KevWal/BasicTracker/Hardware/BT-5/BT-5.brd

## EAGLE design Hardware/BT-5/BT-5.brd (2022-10-12)

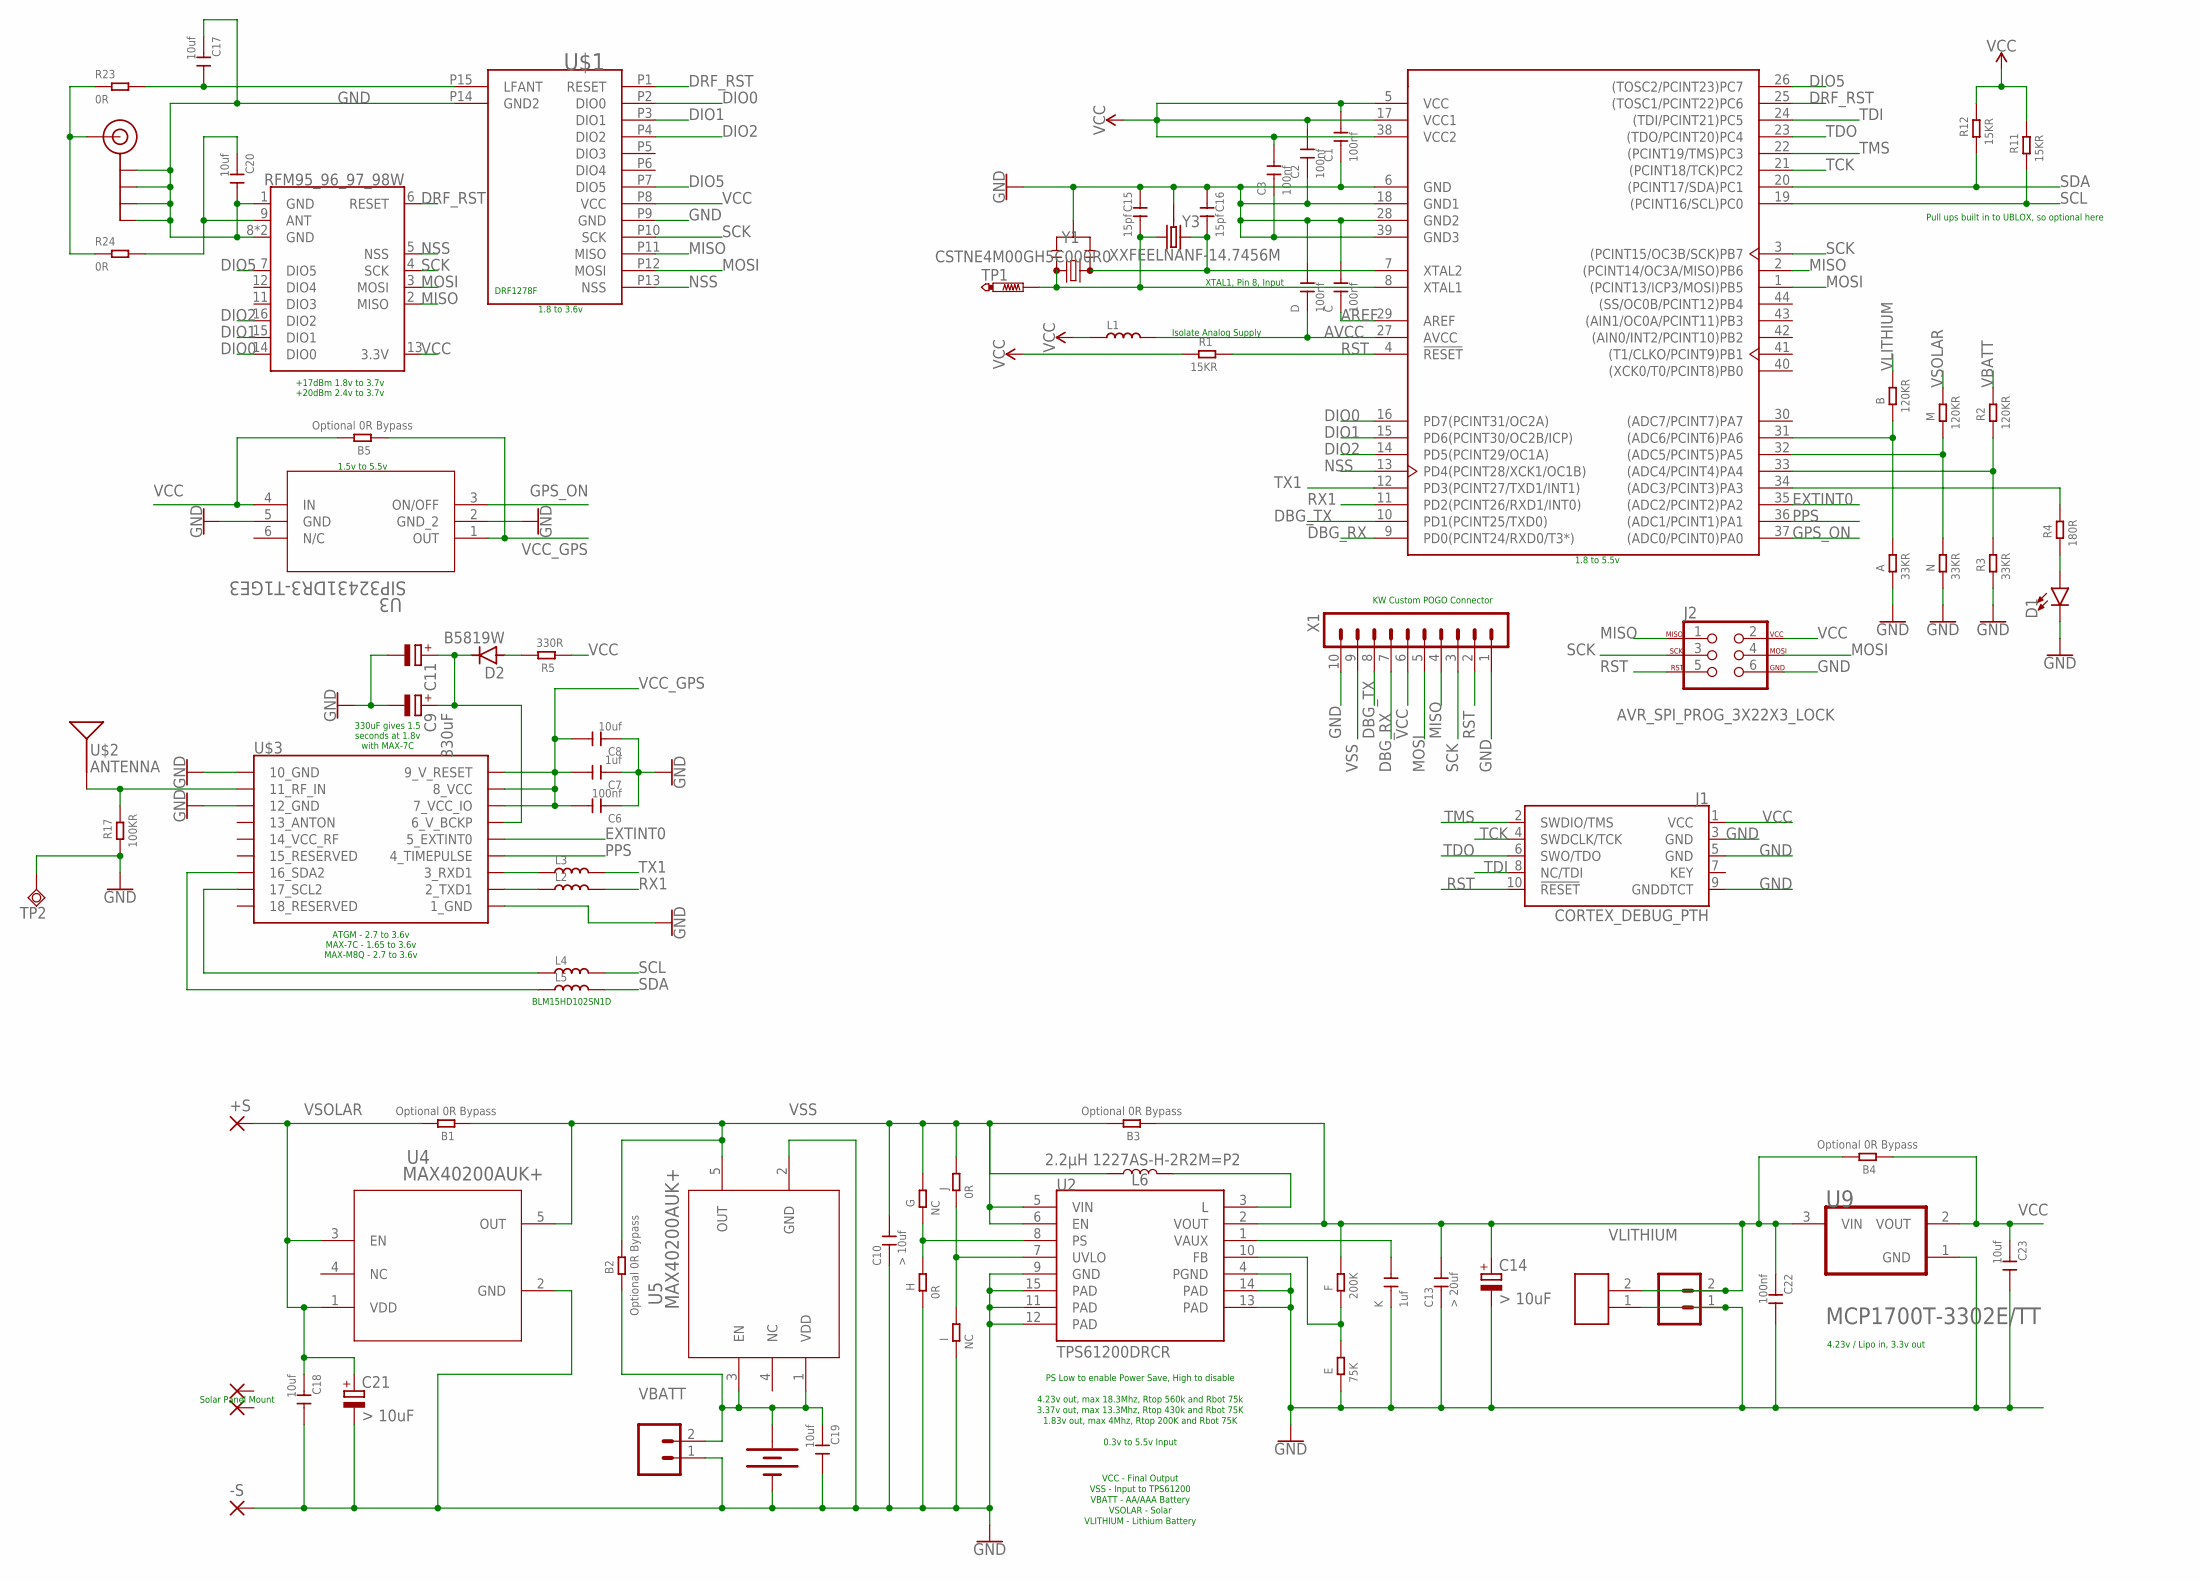
[picture p1: schematic BT-5.sch]

Parts:
+S: SMD2; SMD1,27-2,54
-S: SMD2; SMD1,27-2,54
A: 33KR; R0402
B: 120KR; R0402
B1, B2, B3, B4, B5: Optional 0R Bypass; R0402
BT1: BATTERY; BATTERY-AA-AAA
C, C1, C2, C3, C6, C22: 100nf; C0402
C7: 1uf; C0402
C8, C17, C18, C19, C20, C23: 10uf; C0402
C9: 330uF; RCL_SMC_C
C10: > 10uf; C0603
C11: C-POL_ECAP-10.5MM; CAPAE1030X1050N
C13: > 20uf; C0603
C14, C21: > 10uF; RCL_SMC_C
C15, C16: 15pf; C0402
D: 100nf; C0402
D1: LED0603; LED-0603
D2: B5819W; SOD123; LCSC_PART C8598
E: 75K; R0402
F: 200K; R0402
G: NC; R0402
H: 0R; R0402
I: NC; R0402
J: 0R; R0402
J1: CORTEX_DEBUG_PTH; 2X5-PTH-1.27MM
J2: AVR_SPI_PROG_3X22X3_LOCK; 2X3_LOCK
J4, J6: CONN_02JST-PTH-2-KIT; JST-2-PTH-KIT
J5: JST_ZH_2PIN
J$1: SMA_EDGE; SMA-EDGE
K: 1uf; C0402
L1, L2, L3, L4, L5: BLM15HD102SN1D; L0402
L6: 2.2µH 1227AS-H-2R2M=P2; INDUCTOR_4.7UH; LCSC_PART C435389
M: 120KR; R0402
N: 33KR; R0402
NC1, NC2: SMD2; SMD1,27-2,54
R1, R11, R12: 15KR; R0402
R2: 120KR; R0402
R3: 33KR; R0402
R4: 180R; R0402
R5: 330R; R0402
R17: 100KR; R0402
R23, R24: 0R; R0603
TP1: TESTPAD_PTR1TP10R; TESTPAD_TP10R
TP2: TPSQTP08SQ; TP08SQ
U1: ATMEGA1284P-AU; TQFP-44; LCSC_PART C33575
U2: TPS61200DRCR; QFN-10_PAD; LCSC_PART C140320
U3: SIP32431DR3-T1GE3; SC-70-6_VIS; LCSC_PART C141606
U4, U5: MAX40200AUK+; RAJX_V4.5_REVA_21-0057F_MXM
U6: RFM95_96_97_98W; RFM69HCW-XXXS2
U9: MICROCHIP_MCP1700T-3302E-TTMICROCHIP_MCP1700T-330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; MICROCHIP_MCP1700T-3302E-TT_0
U$1: DRF1278F; DRF1278F_2_NO_PINS
U$2: ANTENNA; ANT-GPS-3X10MM
U$3: AVA_UBLOX_MAX-6
X1: KEW_HF_V13_M_1R10KW_50MIL-H; KEW_HF_V13_M_1R09_50MIL-H
Y1: CSTNE4M00GH5C000R0; SPARKFUN-CLOCKS-KW_RESONATOR-SMD-3.2X1.3
Y3: XXFEELNANF-14.7456M; CRYSTAL-SMD-3.2X2.5MM; LCSC_PART C124311

Connections:
AREF: C.1, U1.29 (AREF)
AVCC: D.1, L1.2, U1.27 (AVCC)
DBG_RX: U1.9 (PD0(PCINT24/RXD0/T3*)), X1.7
DBG_TX: U1.10 (PD1(PCINT25/TXD0)), X1.8
DIO0: U1.16 (PD7(PCINT31/OC2A)), U6.14 (DIO0), U$1.P2 (DIO0)
DIO1: U1.15 (PD6(PCINT30/OC2B/ICP)), U6.15 (DIO1), U$1.P3 (DIO1)
DIO2: U1.14 (PD5(PCINT29/OC1A)), U6.16 (DIO2), U$1.P4 (DIO2)
DIO5: U1.26 ((TOSC2/PCINT23)PC7), U6.7 (DIO5), U$1.P7 (DIO5)
DRF_RST: U1.25 ((TOSC1/PCINT22)PC6), U6.6 (RESET), U$1.P1 (RESET)
EXTINT0: U1.35 ((ADC2/PCINT2)PA2), U$3.5_EXTINT0
FB: E.2, F.1, U2.10 (FB)
GND: -S.1, A.1, BT1.P$2 (-), BT1.P$4 (-), BT1.P$7 (-), BT1.P$8 (-), C.2, C1.1, C2.1, C3.1, C6.1, C7.1, C8.1, C9.-, C10.1, C11.2 (-), C13.1, C14.-, C15.2, C16.2, C17.1, C18.2, C19.2, C20.2, C21.-, C22.2, C23.2, D.2, D1.C, E.1, H.1, I.1, J1.3 (GND), J1.5 (GND), J1.9 (GNDDTCT), J2.6, J4.1, J5.1, J6.1, J$1.GND@0 (GND), J$1.GND@1 (GND), J$1.GND@2 (GND), J$1.GND@3 (GND), K.1, N.1, R3.1, R17.1, TP2.TP, U1.6 (GND), U1.18 (GND1), U1.28 (GND2), U1.39 (GND3), U2.4 (PGND), U2.9 (GND), U2.11 (PAD), U2.12 (PAD), U2.13 (PAD), U2.14 (PAD), U2.15 (PAD), U3.2 (GND_2), U3.5 (GND), U4.2 (GND), U5.2 (GND), U6.1 (GND), U6.8 (GND), U6.10 (GND), U9.1 (GND), U$1.P9 (GND), U$1.P14 (GND2), U$3.1_GND, U$3.10_GND, U$3.12_GND, X1.1, X1.10, Y1.2, Y3.2 (3), Y3.4 (3)
GPS_ON: U1.37 ((ADC0/PCINT0)PA0), U3.3 (ON/OFF)
L: L6.P$2 (2), U2.3 (L)
MISO: J2.1, U1.2 ((PCINT14/OC3A/MISO)PB6), U6.2 (MISO), U$1.P11 (MISO), X1.4
MOSI: J2.4, U1.1 ((PCINT13/ICP3/MOSI)PB5), U6.3 (MOSI), U$1.P12 (MOSI), X1.5
unnamed: C17.2, R23.2, U$1.P15 (LFANT)
unnamed: D1.A, R4.1
unnamed: C15.1, TP1.TP, U1.8 (XTAL1), Y1.3, Y3.3 (2)
unnamed: C16.1, U1.7 (XTAL2), Y1.1, Y3.1
unnamed: R2.1, R3.2, U1.33 ((ADC4/PCINT4)PA4)
unnamed: M.1, N.2, U1.32 ((ADC5/PCINT5)PA5)
unnamed: R4.2, U1.34 ((ADC3/PCINT3)PA3)
unnamed: R17.2, U$2.SIG, U$3.11_RF_IN
unnamed: C9.+, C11.1 (+), D2.C, U$3.6_V_BCKP
unnamed: L3.1, U$3.3_RXD1
unnamed: L2.1, U$3.2_TXD1
unnamed: L4.1, U$3.17_SCL2
unnamed: L5.1, U$3.16_SDA2
unnamed: D2.A, R5.2
unnamed: A.2, B.1, U1.31 ((ADC6/PCINT6)PA6)
unnamed: C20.1, R24.2, U6.9 (ANT)
unnamed: J$1.SIG (SIGNAL), R23.1, R24.1
NSS: U1.13 (PD4(PCINT28/XCK1/OC1B)), U6.5 (NSS), U$1.P13 (NSS)
PPS: U1.36 ((ADC1/PCINT1)PA1), U$3.4_TIMEPULSE
PS: G.1, H.2, U2.8 (PS)
RST: J1.10 (!RESET), J2.5, R1.2, U1.4 (!RESET), X1.2
RX1: L2.2, U1.11 (PD2(PCINT26/RXD1/INT0))
SCK: J2.3, U1.3 ((PCINT15/OC3B/SCK)PB7), U6.4 (SCK), U$1.P10 (SCK), X1.3
SCL: L4.2, R11.1, U1.19 ((PCINT16/SCL)PC0)
SDA: L5.2, R12.1, U1.20 ((PCINT17/SDA)PC1)
TCK: J1.4 (SWDCLK/TCK), U1.21 ((PCINT18/TCK)PC2)
TDI: J1.8 (NC/TDI), U1.24 ((TDI/PCINT21)PC5)
TDO: J1.6 (SWO/TDO), U1.23 ((TDO/PCINT20)PC4)
TMS: J1.2 (SWDIO/TMS), U1.22 ((PCINT19/TMS)PC3)
TX1: L3.2, U1.12 (PD3(PCINT27/TXD1/INT1))
UVLO: I.2, J.1, U2.7 (UVLO)
VAUX: K.2, U2.1 (VAUX)
VBATT: B2.1, BT1.P$1 (+), BT1.P$3 (+), BT1.P$5 (+), BT1.P$6 (+), C19.1, J4.2, R2.2, U5.1 (VDD), U5.3 (EN)
VCC: B4.1, B5.2, C1.2, C2.2, C3.2, C23.1, J1.1 (VCC), J2.2, L1.1, R1.1, R5.1, R11.2, R12.2, U1.5 (VCC), U1.17 (VCC1), U1.38 (VCC2), U3.4 (IN), U6.13 (3.3V), U9.2 (VOUT), U$1.P8 (VCC), X1.6
VCC_GPS: B5.1, C6.2, C7.2, C8.2, U3.1 (OUT), U$3.7_VCC_IO, U$3.8_VCC, U$3.9_V_RESET
VLITHIUM: B.2, B3.1, B4.2, C13.2, C14.+, C22.1, F.2, J5.2, J6.2, U2.2 (VOUT), U9.3 (VIN)
VSOLAR: +S.1, B1.2, C18.1, C21.+, M.2, U4.1 (VDD), U4.3 (EN)
VSS: B1.1, B2.2, B3.2, C10.2, G.2, J.2, L6.P$1 (1), U2.5 (VIN), U2.6 (EN), U4.5 (OUT), U5.5 (OUT), X1.9

Notes on the sheet:
XTAL1, Pin 8, Input
Isolate Analog Supply
KW Custom POGO Connector
DRF1278F
1.8 to 3.6v
1.8 to 5.5v
ATGM - 2.7 to 3.6v MAX-7C - 1.65 to 3.6v MAX-M8Q - 2.7 to 3.6v
Pull ups built in to UBLOX, so optional here
BLM15HD102SN1D
PS Low to enable Power Save, High to disable 4.23v out, max 18.3Mhz, Rtop 560k and Rbot 75k 3.37v out, max 13.3Mhz, Rtop 430k and Rbot 75K 1.83v out, max 4Mhz, Rtop 200K and Rbot 75K 0.3v to 5.5v Input
Solar Panel Mount
VCC - Final Output VSS - Input to TPS61200 VBATT - AA/AAA Battery VSOLAR - Solar VLITHIUM - Lithium Battery
1.5v to 5.5v
+17dBm 1.8v to 3.7v +20dBm 2.4v to 3.7v
4.23v / Lipo in, 3.3v out
330uF gives 1.5 seconds at 1.8v with MAX-7C

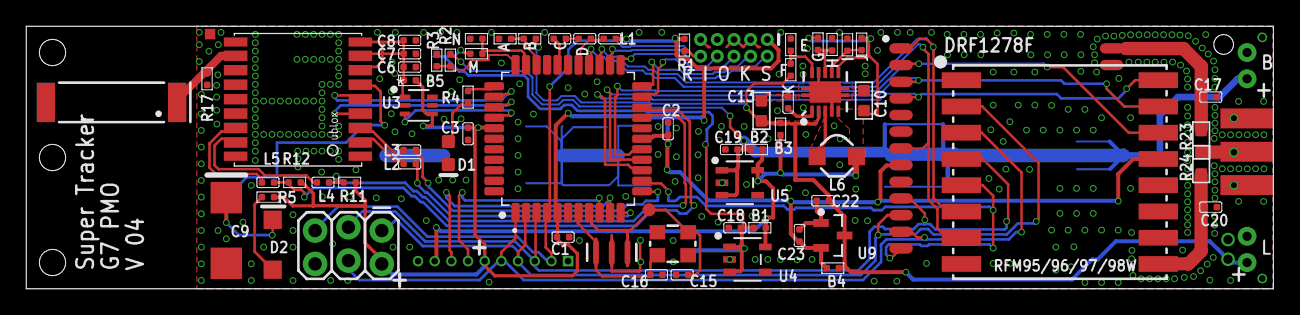
[picture p2: board BT-5.brd from above]

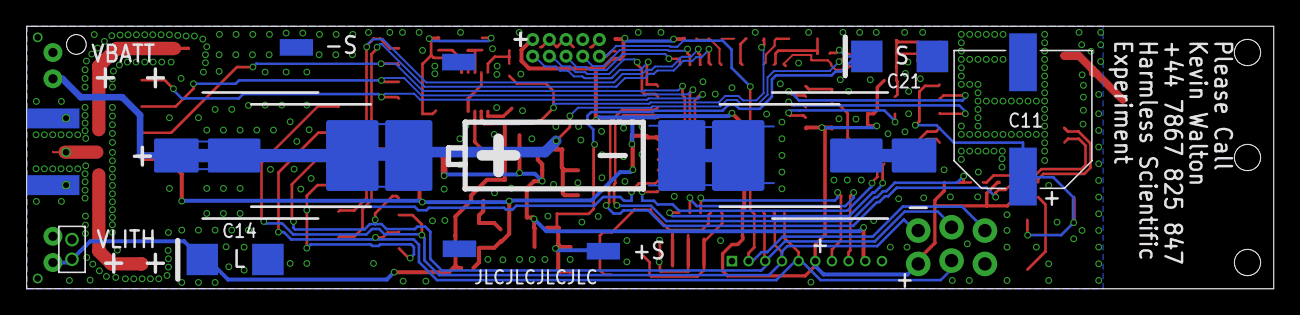
[picture p3: board BT-5.brd from below]

Board: 2 copper layers, 95.0 x 20.0 mm, 82 parts (11 on the bottom side), 54 nets.
