KevWal/BasicTracker/(commit log)

2021-04-28 Move to BT-2
    [BT-1.brd, BT-1.sch, BT-2.brd, BT-2.sch]
2021-05-16 Sent to JLC
    [BT-3.GBL, BT-3.GBO, BT-3.GBP, BT-3.GBS, BT-3.GTL, BT-3.GTO, BT-3.GTP, BT-3.GTS]
2022-11-05 Added RTTY Interrupt based code
    [BT-5.sch]
