KevWal/BasicTracker/(notices)

Notices in the files:
parts and their libraries:
KEW_HF_V16: COPYRIGHT: Copyright (C) 2018 Accelerated Designs. All rights reserved
SparkFun-PowerSymbols: Licensing: Creative Commons ShareAlike 4.0 International - https://creativecommons.org/licenses/by-sa/4.0
